kenbrinkman/aquapi/assets/3D MODELS/ezo-conductivity-circuit-1/Circuito EC.JPG

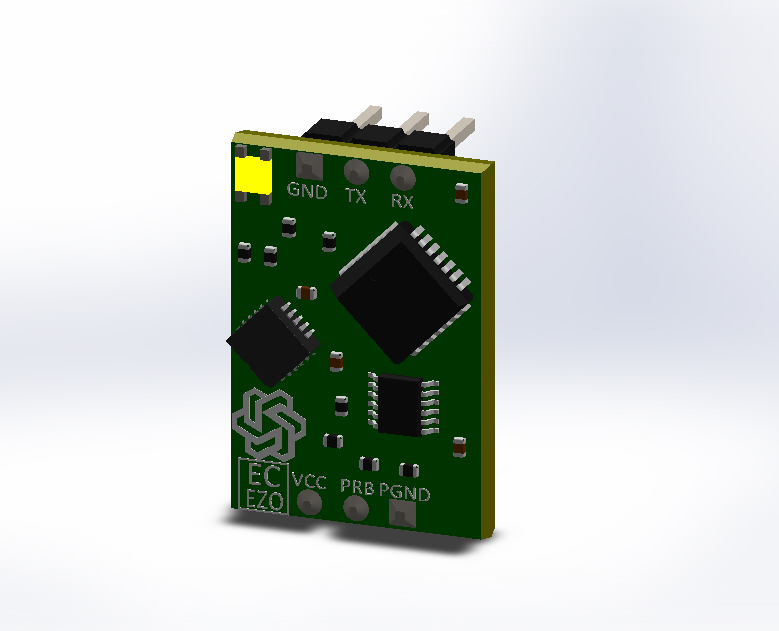
assets/3D MODELS/ezo-conductivity-circuit-1/Circuito EC.JPG
