kenbrinkman/aquapi/assets/STLModels/AquaPiCase/case_views.png

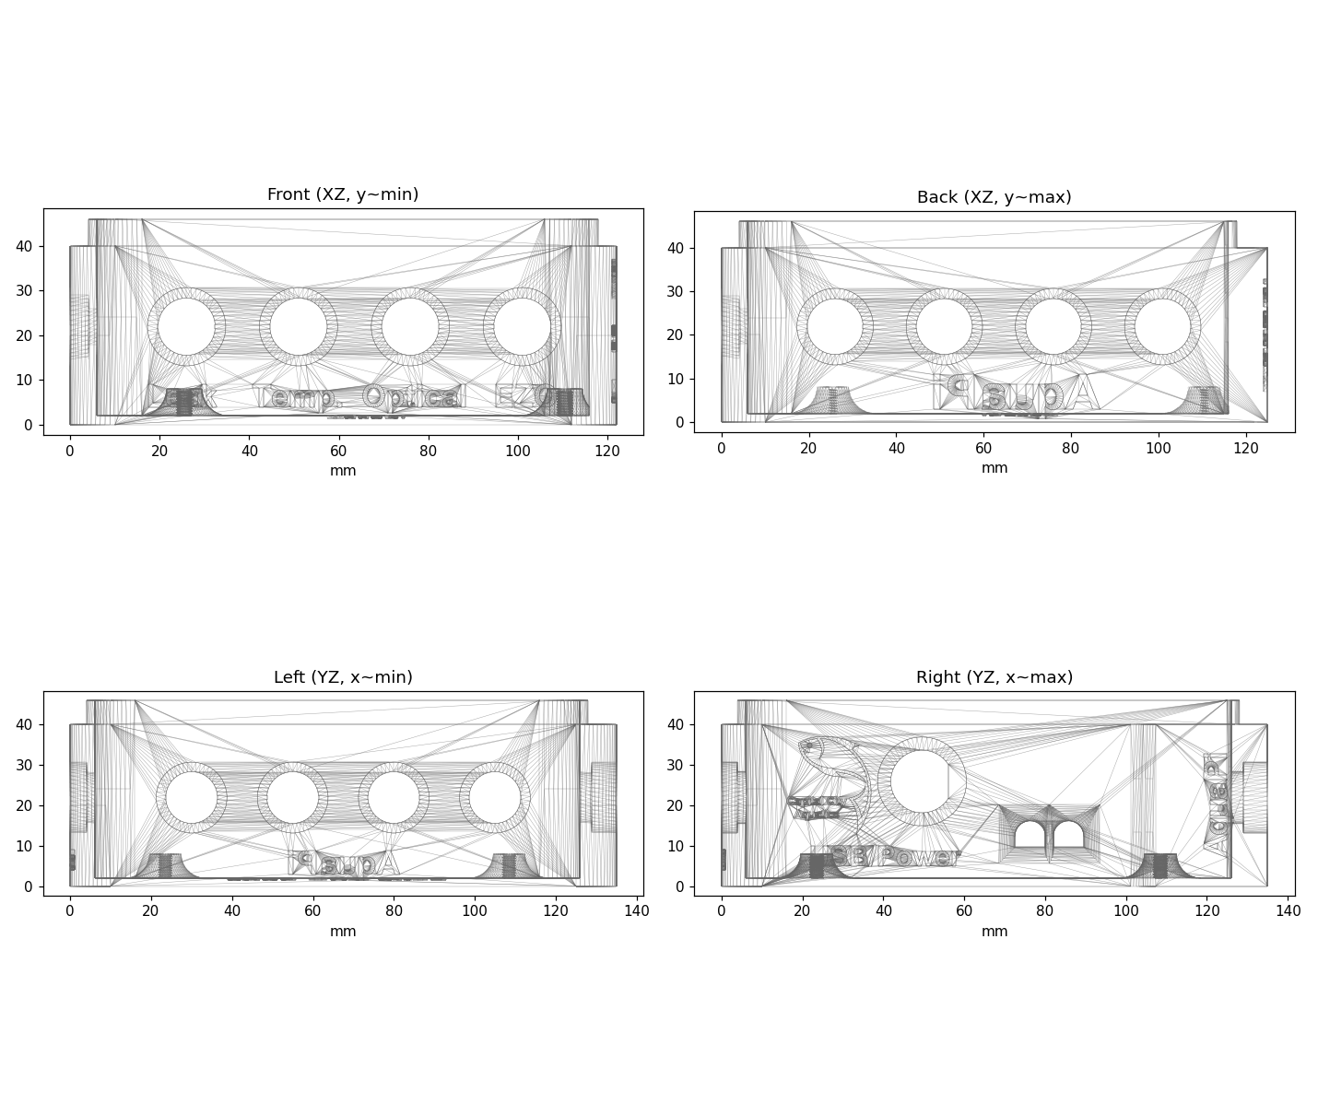
assets/STLModels/AquaPiCase/case_views.png
