kenbrinkman/aquapi/assets/STLModels/AquaPiCase/wall_sections.png

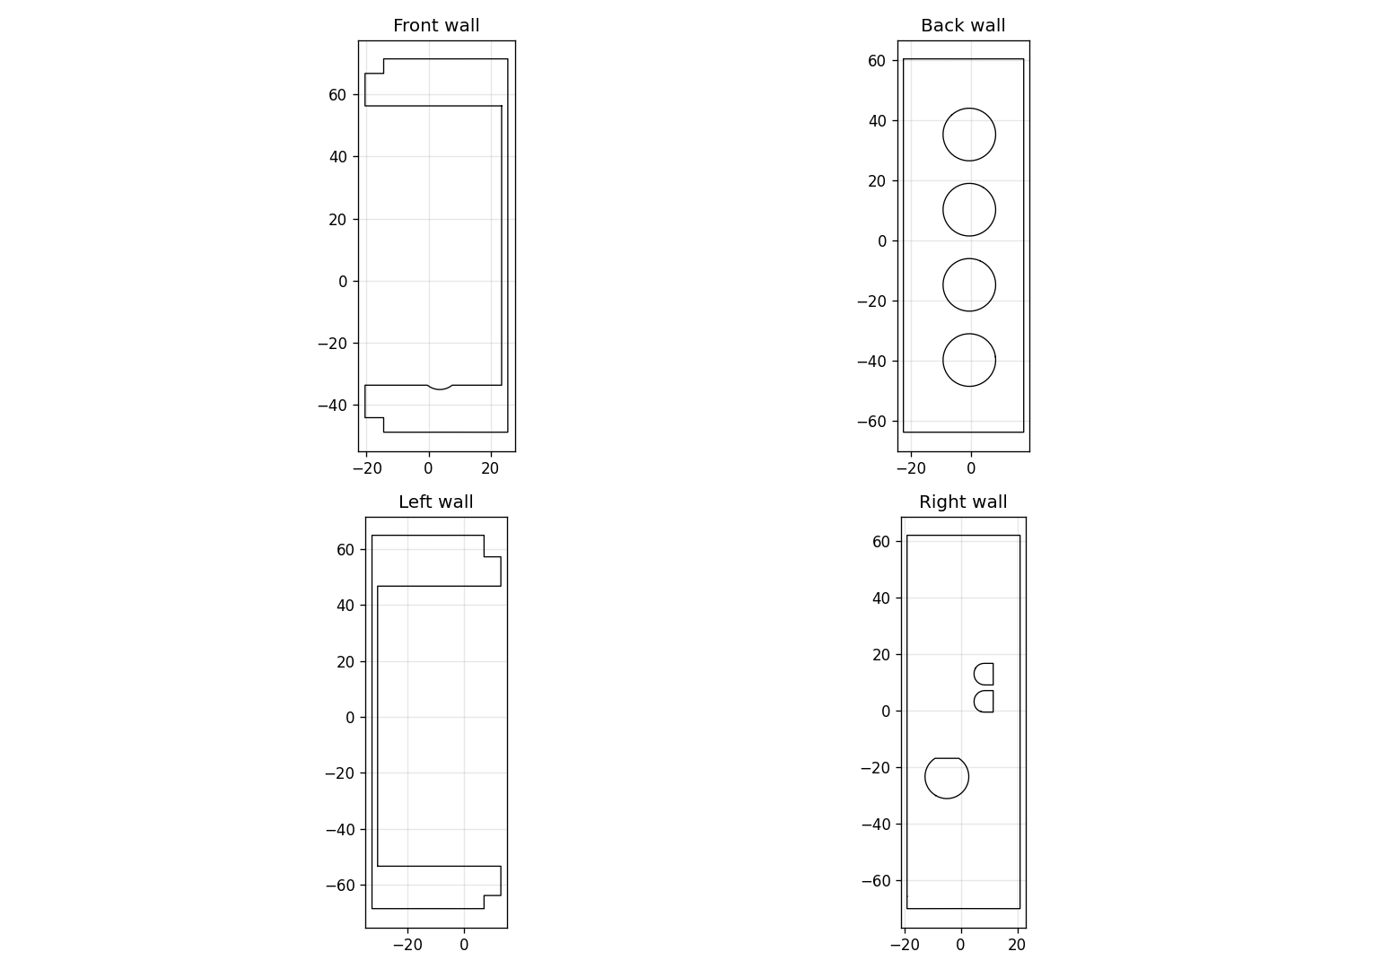
assets/STLModels/AquaPiCase/wall_sections.png
