kenbrinkman/aquapi/assets/3D MODELS/221-415.STEP

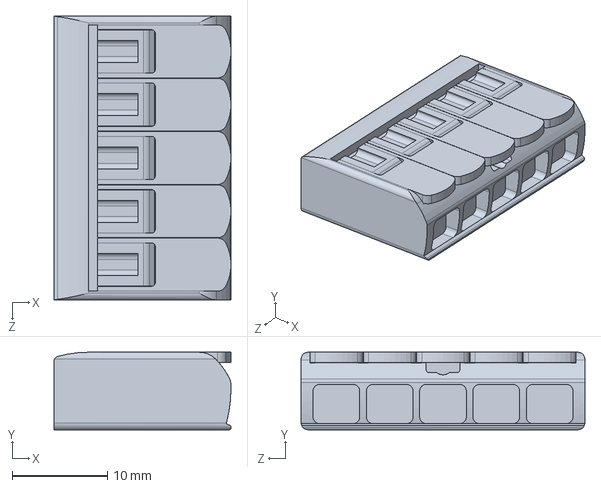
[picture p4: CAD file, 2026-07-17]
assets/3D MODELS/221-415.STEP
18.6 x 8.15 x 29.8 mm
