kenbrinkman/aquapi/assets/3D MODELS/ezo-conductivity-circuit-1/Circuito EC.STEP

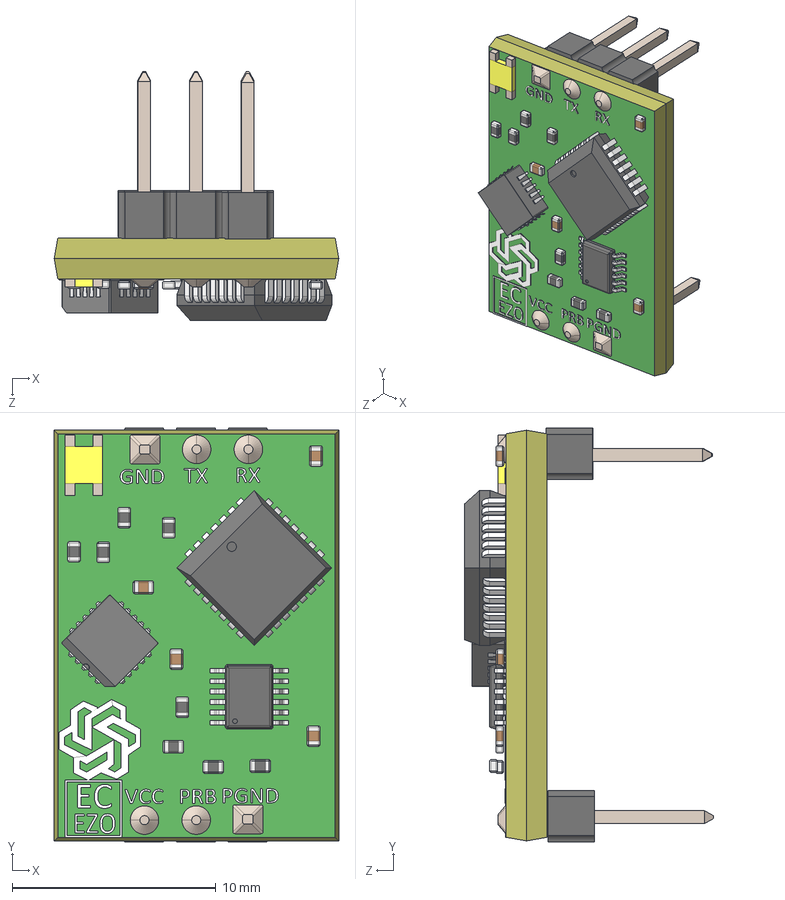
[picture p5: CAD file, 2026-07-17]
assets/3D MODELS/ezo-conductivity-circuit-1/Circuito EC.STEP
14.0 x 20.3 x 12.2 mm
2.terminal x 6
pe蓷 base
1.smd resistor x 8
14.capacitor smd x 4
7.smd 12 terminais___ _________
9. smd pin28
10.PLCC20
