kenbrinkman/aquapi/assets/3D MODELS/PG7.STEP

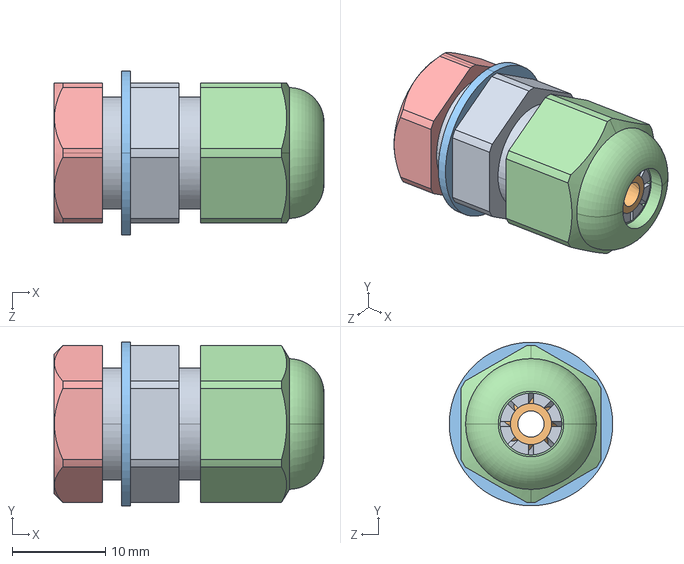
[picture p6: CAD file, 2026-07-17]
assets/3D MODELS/PG7.STEP
28.9 x 17.5 x 17.5 mm
