kenbrinkman/aquapi/assets/3D MODELS/Electrically Isolated EZO Carrier Board.STEP

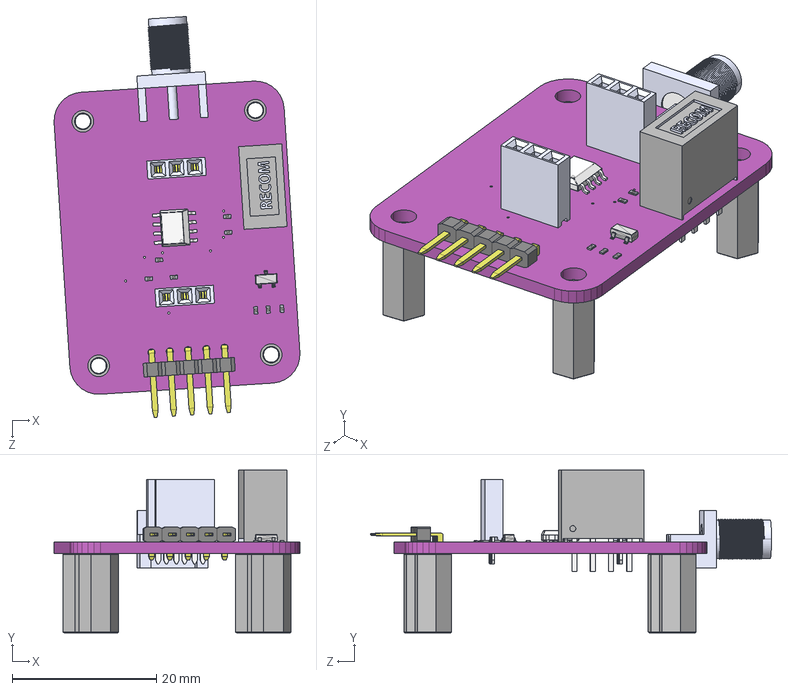
[picture p7: CAD file, 2026-07-17]
assets/3D MODELS/Electrically Isolated EZO Carrier Board.STEP
34.1 x 22.6 x 55.7 mm
standoff x 4
Board_Iso_carry_type-II.step
hdr-1x5th_1.27_6x5.step
User_Library-RO-0505.step
soic-8_150mil.step
hdrf-1x3t_2.54_8x3.step x 2
res_0402.step x 8
sot23.step
SMA edge mount
