kenbrinkman/aquapi/assets/3D MODELS/PG9.STEP

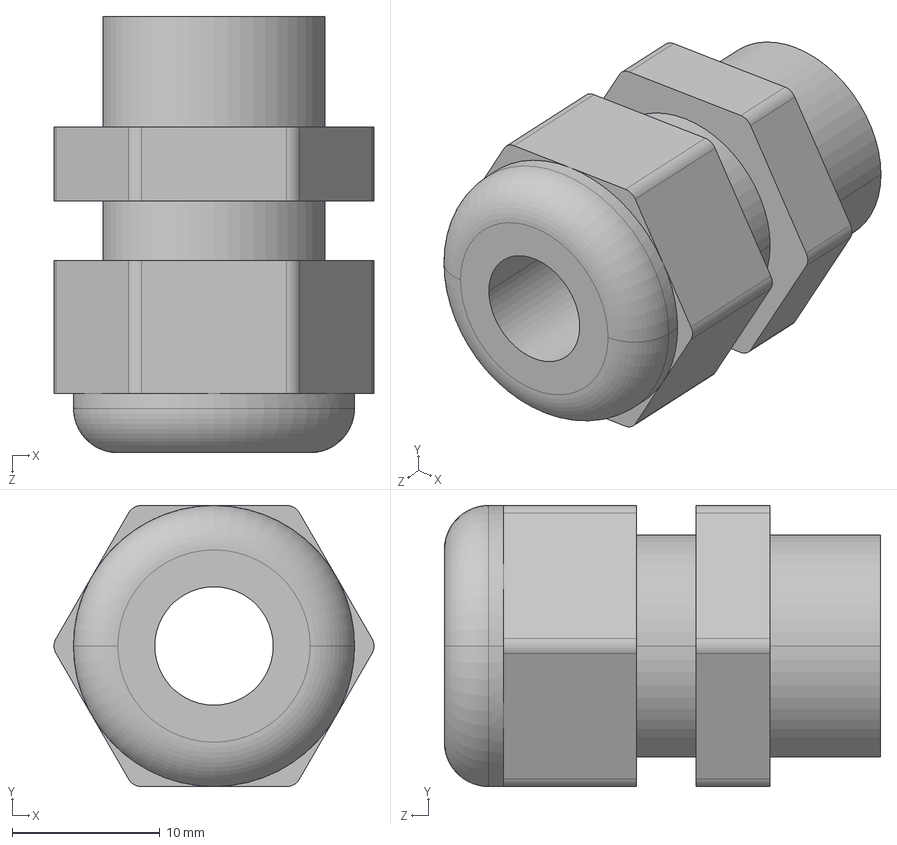
[picture p8: CAD file, 2026-07-17]
assets/3D MODELS/PG9.STEP
21.6 x 19.0 x 29.5 mm
