kenbrinkman/aquapi/assets/3D MODELS/WIZ850IO.STEP

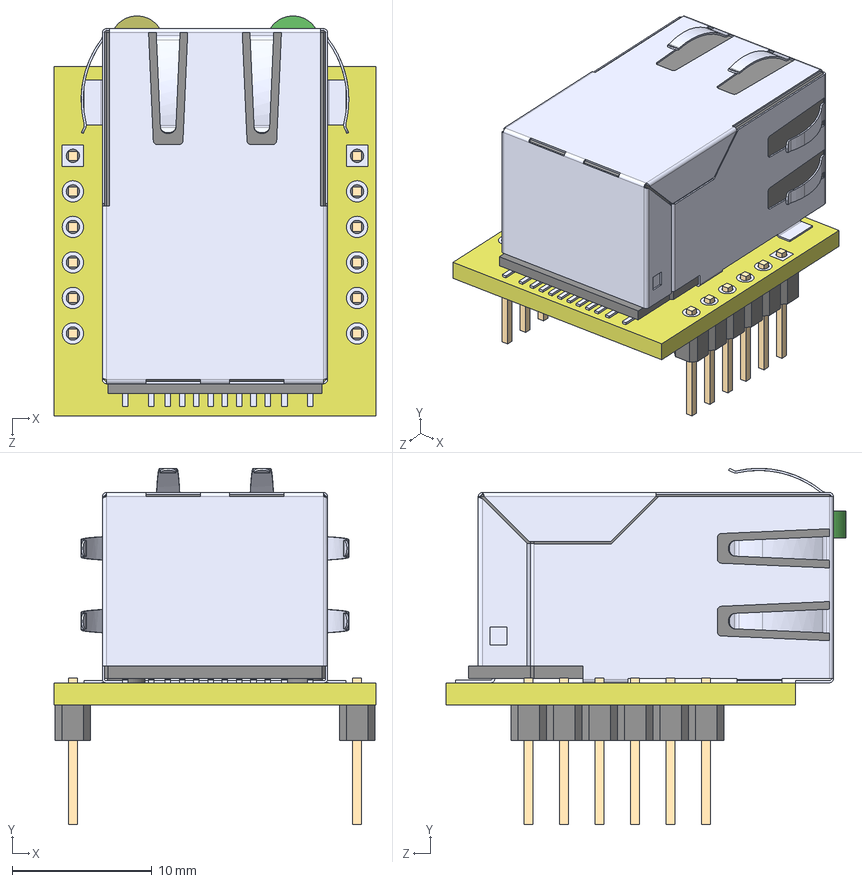
[picture p9: CAD file, 2026-07-17]
assets/3D MODELS/WIZ850IO.STEP
23.0 x 25.5 x 28.6 mm
