kenbrinkman/aquapi/(list of files, cad)

Other CAD files:
assets/3D MODELS/ezo-orp-circuit-1/Circuito ORP.STEP
assets/3D MODELS/ezo-ph-circuit-1/Circuito pH.STEP
assets/3D MODELS/Circuito ORP.stl
assets/3D MODELS/Circuito EC.stl
assets/3D MODELS/Circuito pH.stl
assets/3D MODELS/221-415.stl
assets/3D MODELS/Electrically Isolated EZO Carrier Board.stl
assets/3D MODELS/PG7.stl
assets/3D MODELS/PG9.stl
assets/3D MODELS/WIZ850IO.stl
