kenbrinkman/aquapi/common/temperature_dallas_address.yaml

---
# =============================================================================
# Dallas DS18B20 temperature — ADDRESS-BASED (replaces temperature_dallas_index.yaml)
# =============================================================================
# Why address instead of index:
#   With `index:`, the probes are numbered by their position in the ROM-sorted
#   scan order. If a probe dies or is unplugged, the survivor is promoted to
#   index 0 — so "Temperature" silently starts reporting the *other* probe, and
#   its baked-in calibration is now applied to the wrong sensor. With
#   `address:`, a missing probe simply goes unavailable and the other one keeps
#   reporting itself. Probe swaps become explicit (edit the address here).
#
# HOW TO GET THE ADDRESSES (done 2026-07-30 — kept for the next rebuild):
#   1. Flash with the existing index-based file still included.
#   2. GOTCHA: the bus dump is logged at CONFIG level, which is SUPPRESSED at
#      the default logger level of INFO set in common/device_base_ethernet.yaml.
#      Set `logger: "DEBUG"` in the top-level substitutions of the device YAML
#      first, or the dump never reaches the log and it looks like the reboot
#      failed. Revert to INFO once captured.
#   3. Open the ESPHome logs and look for the one_wire bus dump at boot:
#        [C][gpio.one_wire:020]: GPIO 1-wire bus:
#        [C][gpio.one_wire:087]:   Found devices:
#        [C][gpio.one_wire:090]:     0x8a00000023e44428 (DS18B20)
#        [C][gpio.one_wire:090]:     0xbf00000021744328 (DS18B20)
#   ⚠ CAPTURE GOTCHA (cost a cycle 2026-09-02): the dump is emitted ~3 s after
#      boot, BEFORE the API log stream reconnects. Pressing the Restart button
#      (or HA's restart) while `esphome logs` is attached MISSES IT ENTIRELY —
#      the stream drops on reboot and comes back ~6 s later, after dump_config
#      has already run. You get a clean-looking log with no [C] block at all.
#      USE `esphome run`, which reconnects immediately after its own OTA and
#      reliably catches the dump from [I][app:151] onward.
#      The later [C][dallas.temp.sensor:033] lines are more useful still —
#      they print the address each sensor actually resolved to, in YAML order,
#      which maps index -> address without any guessing.
#   4. Identify which is which: put ONE probe in a cup of warm water, watch
#      which entity moves. Label that physical probe with a tag.
#   5. Paste the addresses below, swap the include, re-flash.
#
# NOTE: the 4.7 kΩ 1-wire pull-up is ALREADY on the AquaPi board (R3, between
# DATA and 3V3). Do not add another — a second pull-up in parallel halves the
# effective resistance and can corrupt reads on longer runs. (REV E.1 of the
# junction box deleted the DROK V1738 carriers, which each carried their own
# on-board 4.7 kΩ; the bus is now on R3 alone, as this note always claimed.)
#
# =============================================================================
# FAILURE VISIBILITY — read this before touching the `filters:` blocks
# =============================================================================
# Until 2026-09-02 both sensors carried `filter_out: NAN` plus a range lambda
# that `return {}`-ed out-of-band values. BOTH OF THOSE DROP THE READING: the
# component publishes nothing, the entity never transitions to unavailable, and
# Home Assistant serves the last good state forever. On 2026-09-01 that hid two
# dead probes for nine days — temp_1 pinned at 74.8625030517578 the whole time,
# indistinguishable from a healthy stable tank.
#
# The rule that came out of it: A FILTER THAT HIDES BAD DATA ALSO HIDES NO DATA.
# So this file now fails loudly, in three layers:
#
#   1. The range lambda returns NAN (not `{}`) for an implausible reading, so
#      the bad value is PUBLISHED as NAN and HA shows "unknown".
#   2. A `timeout:` filter publishes NAN if nothing arrives for ${stale_timeout},
#      which catches a bus that stops answering entirely — a cut wire, a pulled
#      WAGO lever, a ROM address that is not on the bus. No range filter can
#      ever see that case.
#   3. A per-probe `device_class: problem` binary sensor mirrors isnan(), so the
#      fault is a first-class HA entity you can alert and badge on, rather than
#      something you have to notice by staring at a number.
#
# ⚠ If you ever add a plausibility filter to ANY sensor on this device, add the
#   matching staleness check in the SAME change. Never re-introduce
#   `filter_out: NAN` here.
# =============================================================================

substitutions:
  dallasPin: "16"
  update_temp: "60s"

  # Staleness watchdog. If a sensor publishes nothing for this long, emit NAN so
  # the entity goes "unknown" in HA instead of freezing on its last good value.
  # Must be a comfortable multiple of update_temp (60s) so a single missed read
  # does not trip it. 300s == 5 missed reads.
  stale_timeout: "300s"

  # --- Probe ROM addresses -----------------------------------------------
  # 64-bit 1-wire ROM codes. Enumerated on GPIO16 at 12-bit resolution.
  #
  # ✅ CAPTURED 2026-09-06 15:09 — the two NEW DigiKey DS18B20s fitted after the
  #    intermittent DAT/GND short. Both appeared in one boot dump:
  #      [C][gpio.one_wire:090]:     0x40000010ab151428 (DS18B20)
  #      [C][gpio.one_wire:090]:     0x8b000010ab7bbb28 (DS18B20)
  #    Captured with logger: "DEBUG" set in common/reef_overrides.yaml (the LAST
  #    package, so it wins) — NOT by swapping to temperature_dallas_index.yaml,
  #    which still carries the pre-2026-09-02 NAN-dropping filters. See the
  #    warning header on that file; the old "keep _index.yaml for re-reading
  #    addresses" advice is retired.
  #
  # ✅ T1/T2 MAPPING VERIFIED 2026-09-06 ~15:20 — hand-warm test, one probe at a
  #    time. Lifted the probe wired to the T1 terminal, held it in hand, watched
  #    'Temperature' rise and 'Temperature 2' hold. Returned it, lifted the T2
  #    probe, watched 'Temperature 2' rise. Both tracked their own entity, so the
  #    assignment below is CONFIRMED, not inferred from dump order.
  #
  # 🔑 The addresses were pasted in blind (a coin flip) and came out right, but
  #    do NOT read that as "the dump order matches YAML order" — it does not, and
  #    it was luck. The hand-warm test is what makes this line trustworthy.
  #
  # ⚠ Keep the hand-warm under ~100 °F. The range lambda below NANs anything
  #   above 40 °C (104 °F), so a hot-water cup makes a healthy probe read
  #   "unknown" mid-test and look like the failure you are testing for. Body
  #   heat is ideal: it moved both probes ~5 °F, which is far more than enough.
  #
  # 🔑 BONUS, worth remembering: the hand-warm doubles as a LIVENESS KICK. HA's
  #   reef_sump_t{1,2}_movement_1h helpers (statistics, distance_absolute) sat at
  #   0.0 after the outage because the sump was drifting at only 0.20 °F/h and
  #   the 12-bit quantum is 0.1125 °F — a HEALTHY probe needs ~34 min to move one
  #   step, so the vote would not seat the second probe for half an hour. Warming
  #   each probe by hand pushed both helpers to 5.06 and the verdict reached OK
  #   within two minutes.
  #
  # For a future rebuild, the zero-inference method (no hand-warm needed):
  #    boot with ONLY the T1 probe's DAT lever closed. The bus dump then lists
  #    exactly ONE address — that is addr_temp_1. Close T2's lever, reboot, and
  #    the newly appeared address is addr_temp_2.
  #
  # HISTORICAL — superseded, kept so an old log line can still be identified:
  #    0xbf00000021744328 / 0x8a00000023e44428  dead Amazon/clone probes (7/30)
  #    0xb100000025f23928 / 0x6e00000025e47428  Olimex probes, removed 9/06 after
  #                                             the intermittent short (torched
  #                                             heat-shrink, see project docs)
  addr_temp_1: "0x40000010ab151428"  # T1 terminal — DigiKey, hand-warm verified 9/06
  addr_temp_2: "0x8b000010ab7bbb28"  # T2 terminal — DigiKey, hand-warm verified 9/06

  # ✅ CAPTURED 2026-09-08 23:54 — junction box REV F, third probe on the bus.
  #    Boot dump (logger DEBUG, build 26.6.11) listed T1, T2 and exactly ONE new
  #    address, so this needs no inference. ✅ CONFIRMED 2026-09-08 00:00 — hot tap
  #    then cold on the AMB tip moved only 'Basement Ambient Temperature'; T1 in
  #    hand moved only 'Temperature'. All three mappings physically proven.
  # ⚠ AMB is BASEMENT AIR, not a sump probe. It must never be referenced from
  #   temp_delta, temp_probes_disagree, or any HA vote/verdict helper
  #   (reef_sump_probes_ok, reef_temp_verdict, the *_movement_1h helpers).
  #   A basement-air voter sits 5–10 °F off the sump and fails the band forever.
  addr_temp_amb: "0x9b000010ab5d7e28"  # AMB terminal — DigiKey, basement ambient
  stale_timeout_amb: "300s"

  # Calibration variables
  # 0C using Ice Water; 100C using Boiling Water
  # (calibration happens in °C, before the °F conversion filter)
  #
  # Calibration Temp. 1
  # RESET 2026-07-28 for the rebuilt probe harness. The previous
  # cal_0/cal_100 of 0.389/100.389 was a +0.7°F bias offset derived on
  # 2026-07-08 against the OLD T2 as reference — that reference probe is
  # dead and both probes are being re-terminated, so the old offset is
  # meaningless. Re-derive after the rebuild: let both probes settle in the
  # same water, then bias whichever reads low.
  cal_0: "0.0"
  cal_100: "100.0"
  # Cool/Warm thresholds in °F (was 23.5/28 °C)
  range_cool: "74.3"
  range_warm: "82.4"

  # Calibration Temp. 2
  cal_0_temp_2: "0.0"
  cal_100_temp_2: "100.0"
  range_cool_2: "74.3"
  range_warm_2: "82.4"

  sorting_group_temperature_weight: '10'

web_server:
  sorting_groups:
    - id: sorting_group_temperature
      name: "Temperature"
      sorting_weight: ${sorting_group_temperature_weight}

# 18B20 sensor Pin
one_wire:
  - platform: gpio
    pin: ${dallasPin}

sensor:
  # Temperature Probe 1 - pinned to its ROM address
  - platform: dallas_temp
    address: ${addr_temp_1}
    id: temp_1
    icon: mdi:thermometer-water
    name: "Temperature"
    state_class: "measurement"
    device_class: "temperature"
    unit_of_measurement: "°F"
    update_interval: "${update_temp}"
    resolution: 12
    accuracy_decimals: 2
    filters:
      # ⚠ DELIBERATELY NO `filter_out: NAN` — see FAILURE VISIBILITY in the header.
      # Reject implausible raw readings (°C, pre-calibration) by PUBLISHING NAN,
      # never by dropping them: 85.0 = DS18B20 power-on-reset default,
      # 0.0 / -127 = bus glitch. Outside 4-40°C (39-104°F) is not a tank temp.
      - lambda: |-
          if (isnan(x) || x < 4.0 || x > 40.0) return NAN;
          return x;
      - calibrate_linear:
          method: least_squares
          datapoints:
            - 0.0 -> ${cal_0}
            - 100.0 -> ${cal_100}
      # Convert to Fahrenheit (calibration above stays in °C)
      - lambda: return x * 9.0 / 5.0 + 32.0;
      # Watchdog — MUST BE LAST. Nothing published for ${stale_timeout} -> NAN.
      # This is the layer that catches a bus which stops answering completely.
      - timeout: ${stale_timeout}
    on_value:
      then:
        - component.update: temp_range
    web_server:
      sorting_group_id: sorting_group_temperature
      sorting_weight: 10

  # Calibration Temp. at 0C
  - platform: template
    name: Calibration at 0°C - Temp. 1
    id: cal_0_sen
    icon: mdi:thermometer-low
    unit_of_measurement: "°C"
    disabled_by_default: true
    state_class: "measurement"
    device_class: "temperature"
    entity_category: "diagnostic"
    lambda: |-
      return {${cal_0}};
    web_server:
      sorting_group_id: sorting_group_temperature

  # Calibration Temp. at 100C
  - platform: template
    name: Calibration at 100°C - Temp. 1
    id: cal_100_sen
    icon: mdi:thermometer-high
    unit_of_measurement: "°C"
    disabled_by_default: true
    state_class: "measurement"
    device_class: "temperature"
    entity_category: "diagnostic"
    lambda: |-
      return {${cal_100}};
    web_server:
      sorting_group_id: sorting_group_temperature

  # Temperature Probe 2 - pinned to its ROM address
  - platform: dallas_temp
    address: ${addr_temp_2}
    id: temp_2
    icon: mdi:thermometer-water
    name: "Temperature 2"
    state_class: "measurement"
    device_class: "temperature"
    unit_of_measurement: "°F"
    update_interval: "${update_temp}"
    resolution: 12
    accuracy_decimals: 2
    filters:
      # ⚠ DELIBERATELY NO `filter_out: NAN` — see Temp 1 and the header.
      - lambda: |-
          if (isnan(x) || x < 4.0 || x > 40.0) return NAN;
          return x;
      - calibrate_linear:
          method: least_squares
          datapoints:
            - 0.0 -> ${cal_0_temp_2}
            - 100.0 -> ${cal_100_temp_2}
      # Convert to Fahrenheit (calibration above stays in °C)
      - lambda: return x * 9.0 / 5.0 + 32.0;
      # Watchdog — MUST BE LAST. See Temp 1.
      - timeout: ${stale_timeout}
    on_value:
      then:
        - component.update: temp_range_2
    web_server:
      sorting_group_id: sorting_group_temperature
      sorting_weight: 60

  # Calibration Temp. 2 at 0C
  - platform: template
    name: Calibration at 0°C - Temp. 2
    id: cal_0_2_sen
    disabled_by_default: true
    icon: mdi:thermometer-low
    unit_of_measurement: "°C"
    state_class: "measurement"
    device_class: "temperature"
    entity_category: "diagnostic"
    lambda: |-
      return {${cal_0_temp_2}};
    web_server:
      sorting_group_id: sorting_group_temperature
      sorting_weight: 69

  # Calibration Temp. 2 at 100C
  - platform: template
    name: Calibration at 100°C - Temp. 2
    id: cal_100_2_sen
    disabled_by_default: true
    icon: mdi:thermometer-high
    unit_of_measurement: "°C"
    state_class: "measurement"
    device_class: "temperature"
    entity_category: "diagnostic"
    lambda: |-
      return {${cal_100_temp_2}};
    web_server:
      sorting_group_id: sorting_group_temperature
      sorting_weight: 69

  # --- Basement ambient — a SENSOR, not a voter ------------------------------
  # Third DS18B20 on the same bus (R3 is still the only pull-up). Reports the air
  # around the sump so HA can later derive sump − ambient for the cooling
  # decision. Never reference this id from temp_delta / temp_probes_disagree or
  # from any HA sump-vote helper. Range is AIR (-5..50 °C), not tank, and the
  # staleness watchdog ships in the same change, per the header rule.
  - platform: dallas_temp
    address: ${addr_temp_amb}
    id: temp_amb
    icon: mdi:thermometer
    name: "Basement Ambient Temperature"
    state_class: "measurement"
    device_class: "temperature"
    unit_of_measurement: "°F"
    update_interval: "${update_temp}"
    resolution: 12
    accuracy_decimals: 2
    filters:
      # ⚠ NO filter_out: NAN — publish NAN so HA shows unknown (see header).
      # 85.0 = DS18B20 power-on default, -127 / 0.0 = bus glitch.
      - lambda: |-
          if (isnan(x) || x < -5.0 || x > 50.0) return NAN;
          return x;
      - lambda: return x * 9.0 / 5.0 + 32.0;
      # Watchdog — MUST BE LAST.
      - timeout: ${stale_timeout_amb}
    web_server:
      sorting_group_id: sorting_group_temperature
      sorting_weight: 80

  # --- Probe agreement --------------------------------------------------------
  # T1 and T2 sit in the SAME 75 gal sump, so in steady state they must track
  # each other. This is the ONLY check that can catch a probe frozen on a
  # PLAUSIBLE value — the failure mode that hid two dead probes for nine days.
  # A range filter cannot see it (74.86°F is a perfectly sensible tank temp) and
  # neither can the ${stale_timeout} watchdog (a frozen DS18B20 keeps happily
  # publishing its stale scratchpad value every ${update_temp}). But real sump
  # temperature drifts a couple of °F across a day, so a stuck probe walks away
  # from its neighbour within hours and this number climbs.
  #
  # NAN if EITHER probe is faulted — a missing probe is reported by the
  # "Temp Probe Fault" sensors, not here, so the two alerts stay independent.
  - platform: template
    name: "Temp Probe Disagreement"
    id: temp_delta
    icon: mdi:thermometer-minus
    unit_of_measurement: "°F"
    accuracy_decimals: 2
    state_class: "measurement"
    device_class: "temperature"
    entity_category: "diagnostic"
    update_interval: "${update_temp}"
    lambda: |-
      if (isnan(id(temp_1).state) || isnan(id(temp_2).state)) {
        return NAN;
      }
      return fabs(id(temp_1).state - id(temp_2).state);
    web_server:
      sorting_group_id: sorting_group_temperature
      sorting_weight: 70

binary_sensor:
  - platform: template
    name: Ideal Temperature
    id: ideal_temp
    icon: mdi:thermometer-check
    lambda: |-
      if (id(temp_range).state == "OK") {
        return true;
      } else {
        return false;
      }
    web_server:
      sorting_group_id: sorting_group_temperature

  - platform: template
    name: Ideal Temperature 2
    id: ideal_temp_2
    icon: mdi:thermometer-check
    lambda: |-
      if (id(temp_range_2).state == "OK") {
        return true;
      } else {
        return false;
      }
    web_server:
      sorting_group_id: sorting_group_temperature
      sorting_weight: 69

  # --- Probe fault ------------------------------------------------------------
  # device_class problem => true means PROBLEM (HA renders "Detected" / red).
  # Faulted whenever the sensor holds no valid number, which now covers every
  # failure mode: probe unplugged or dead, ROM address not present on the bus
  # (e.g. a probe was swapped and addr_temp_* above was not updated), an
  # implausible reading such as the 85°C power-on-reset value, or the
  # ${stale_timeout} watchdog having fired on a silent bus.
  #
  # This is the entity to alert on. Do NOT alert on the temperature going
  # "unavailable" — that only ever fires when the whole AquaPi drops off the
  # network, never when a single probe dies.
  - platform: template
    name: "Temp Probe Fault"
    id: temp_1_fault
    icon: mdi:thermometer-alert
    device_class: problem
    lambda: |-
      return isnan(id(temp_1).state);
    web_server:
      sorting_group_id: sorting_group_temperature
      sorting_weight: 13

  - platform: template
    name: "Temp Probe 2 Fault"
    id: temp_2_fault
    icon: mdi:thermometer-alert
    device_class: problem
    lambda: |-
      return isnan(id(temp_2).state);
    web_server:
      sorting_group_id: sorting_group_temperature
      sorting_weight: 63

  # Ambient probe fault — same isnan() mirror as the sump probes. Diagnostic;
  # it is NOT part of the sump pair and must not feed reef_temp_fault.
  - platform: template
    name: "Ambient Temp Probe Fault"
    id: temp_amb_fault
    icon: mdi:thermometer-alert
    device_class: problem
    entity_category: diagnostic
    lambda: |-
      return isnan(id(temp_amb).state);
    web_server:
      sorting_group_id: sorting_group_temperature
      sorting_weight: 81

  # Trips when the two probes drift apart by more than the configurable
  # threshold. delayed_on debounces it: a single odd sample, or the transient
  # while one probe is lifted out of the water for service, must not alarm.
  #
  # Returns false while the delta is NAN. That is deliberate: a faulted probe is
  # already reported by "Temp Probe Fault", and double-alarming one failure as
  # two problems is how alerting gets ignored.
  - platform: template
    name: "Temp Probes Disagree"
    id: temp_probes_disagree
    icon: mdi:thermometer-alert
    device_class: problem
    filters:
      - delayed_on: 15min
    lambda: |-
      if (isnan(id(temp_delta).state)) {
        return false;
      }
      return id(temp_delta).state > id(temp_delta_max).state;
    web_server:
      sorting_group_id: sorting_group_temperature
      sorting_weight: 71

text_sensor:
  # Temperature Range 1
  - platform: template
    name: Temperature Range
    id: temp_range
    icon: mdi:thermometer-alert
    update_interval: "${update_temp}"
    lambda: |-
      if (isnan(id(temp_1).state)) {
        return {"Unknown"};
      } else if (id(temp_1).state <= id(range_cool).state) {
        return {"Cool"};
      } else if (id(temp_1).state >= id(range_warm).state) {
        return {"Warm"};
      } else {
        return {"OK"};
      }
    web_server:
      sorting_group_id: sorting_group_temperature
      sorting_weight: 12

  # Temperature Range 2
  - platform: template
    name: Temperature 2 Range
    id: temp_range_2
    icon: mdi:thermometer-alert
    update_interval: "${update_temp}"
    lambda: |-
      if (isnan(id(temp_2).state)) {
        return {"Unknown"};
      } else if (id(temp_2).state <= id(range_cool_2).state) {
        return {"Cool"};
      } else if (id(temp_2).state >= id(range_warm_2).state) {
        return {"Warm"};
      } else {
        return {"OK"};
      }
    web_server:
      sorting_group_id: sorting_group_temperature
      sorting_weight: 62

number:
  # Temperature 1 when Cool
  # NOTE: renamed °C -> °F. The new object_id resets the saved (restore_value)
  # threshold, so the °F initial_value takes effect on first boot after flash.
  - platform: template
    name: "Temp. Cool °F"
    id: range_cool
    icon: mdi:thermometer-low
    optimistic: true
    mode: box
    min_value: 32
    max_value: 104
    step: 0.5
    restore_value: true
    initial_value: ${range_cool}
    entity_category: "Config"
    device_class: "temperature"
    on_value:
      then:
        - component.update: temp_range
    web_server:
      sorting_group_id: sorting_group_temperature

  # Temperature 1 when Warm
  - platform: template
    name: "Temp. Warm °F"
    icon: mdi:thermometer-high
    id: range_warm
    optimistic: true
    mode: box
    min_value: 32
    max_value: 104
    step: 0.5
    restore_value: true
    initial_value: ${range_warm}
    entity_category: "Config"
    device_class: "temperature"
    on_value:
      then:
        - component.update: temp_range
    web_server:
      sorting_group_id: sorting_group_temperature

  # Temperature 2 when Cool
  - platform: template
    name: "Temp. 2 Cool °F"
    id: range_cool_2
    icon: mdi:thermometer-low
    optimistic: true
    mode: box
    min_value: 32
    max_value: 104
    step: 0.5
    restore_value: true
    initial_value: ${range_cool_2}
    entity_category: "Config"
    device_class: "temperature"
    on_value:
      then:
        - component.update: temp_range_2
    web_server:
      sorting_group_id: sorting_group_temperature
      sorting_weight: 69

  # Temperature 2 when Warm
  - platform: template
    name: "Temp. 2 Warm °F"
    icon: mdi:thermometer-high
    id: range_warm_2
    optimistic: true
    mode: box
    min_value: 32
    max_value: 104
    step: 0.5
    restore_value: true
    initial_value: ${range_warm_2}
    entity_category: "Config"
    device_class: "temperature"
    on_value:
      then:
        - component.update: temp_range_2
    web_server:
      sorting_group_id: sorting_group_temperature
      sorting_weight: 69

  # Max tolerated spread between the two sump probes before "Temp Probes
  # Disagree" trips. Genuine DS18B20-to-DS18B20 spread on the bench after the
  # 2026-07-30 flash was 0.2°F, and datasheet tolerance is +/-0.9°F, so 1.0°F is
  # comfortably above honest disagreement while still catching a stuck probe
  # within hours of it sticking. Tune DOWN once both probes are wet, settled and
  # calibrated — the tighter this is, the sooner a freeze is caught.
  - platform: template
    name: "Temp Probe Max Disagreement °F"
    id: temp_delta_max
    icon: mdi:thermometer-alert
    optimistic: true
    mode: box
    min_value: 0.1
    max_value: 10
    step: 0.1
    restore_value: true
    initial_value: 1.0
    entity_category: "Config"
    device_class: "temperature"
    web_server:
      sorting_group_id: sorting_group_temperature
      sorting_weight: 72
