kenbrinkman/aquapi/(commit log)

2026-07-07 Add live temperature compensation to EC, pH, and DO circuits
2026-07-12 Pre-flash checkpoint: Ethernet build + GR-402B RODI flow meter on GPIO27
    - rodi_flow.yaml: flow rate (gal/h), lifetime total (gal, restored), new
    'RODI This Run' session volume, producing threshold converted to gal/h
    - Ethernet variant files (W5500 base, binary without leak sensor)
    - EC scoring rescaled for seawater (mS/cm)
    [temperature_dallas_index.yaml, water_quality.yaml]
2026-07-12 Add Ethernet build wiring reference (W5500, GR-402B flow meter, optical sensors)
2026-07-17 RODI flow meter: power moved 3V3 -> 5V aux terminal (2026-07-12)
    Keeps load off the shared 3V3 rail (I2C + W5500). Signal stays GPIO-safe:
    open-collector output only pulls low; line idles at 3.3 V via the internal
    pull-up. Wiring-only change, no firmware impact. Also ignore .DS_Store.
2026-07-17 Reconcile optical LOW/HIGH pin comments with flashed firmware
    Canonical: LOW = GPIO33, HIGH = GPIO32. As wired on this board:
    yellow harness leg = HIGH/D32, blue leg (pigtail white) = LOW/D33 —
    opposite the old harness color convention. Verified against the compiled
    aquapi_config_ethernet.yaml. water_level.yaml remains authoritative.
2026-07-17 Add reference assets: EZO/W5500/case 3D models, case renders, WIZ850io datasheet
    [221-415.STEP, 221-415.stl, Circuito EC.STEP, Circuito EC.stl, Circuito ORP.STEP, Circuito ORP.stl, Circuito pH.STEP, Circuito pH.stl]
2026-07-26 EZO Plock buttons + I2C presence detection; bump app_version to 26.6.7
    EC circuit booted into UART mode after the ferrule/reseat repair (green LED,
    others blue). The EZO hardware protocol switch is 'TX shorted to PGND at
    power-up with RX not driving', and that procedure is identical in both
    directions, so a qualifying boot toggles the protocol every time. EC is the
    only circuit with a low-impedance probe path to PGND (~48 mS/cm seawater);
    pH/ORP/DO are gigaohm potentiometric. Plock,1 blocks the hardware switch.
    - common/ezo_lock.yaml: Lock/Unlock buttons for the 4 installed circuits.
    - common/i2c_detection_reef.yaml: per-circuit bus-presence sensors.
    - common/aquapi.yaml: app_version 26.6.6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
2026-07-28 DS18B20: migrate from bus index to ROM address
    - New common/temperature_dallas_address.yaml: sensors pinned to
    addr_temp_1/addr_temp_2 ROM substitutions instead of index 0/1, so a
    dead probe goes unavailable instead of silently promoting the survivor
    (and its calibration) to index 0
    - Commented address-based dallas: include staged in all three configs,
    ready to flip once the ROM codes are read from a boot log
    - Cal offsets reset to 0.0/100.0 (old T1 bias was derived against the
    now-dead T2); re-derive after the harness rebuild
    - isnan guard moved to the front of the temp_range lambdas; 4-40 C
    plausibility filter carried in both files
    - Entity names/IDs/weights byte-identical to t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
    [temperature_dallas_address.yaml]
2026-07-31 DS18B20: cut over to ROM addressing, drop stale T1 calibration
    Probe ROM codes read off the boot log after the REV D.2 junction box
    rebuild, so the Ethernet build now pins sensors to addresses instead of
    bus index:
    addr_temp_1: 0xbf00000021744328 # T1 terminal
    addr_temp_2: 0x8a00000023e44428 # T2 terminal
    A dead probe now goes unavailable instead of promoting the survivor to
    index 0 and silently reporting it as the tank temp under the dead
    probe's calibration -- which is exactly what happened after the 7/27
    probe failure.
    Calibration: both probes now run uncalibrated (0.0/100.0). The old
    0.389/100.389 bias on T1 was derived on 2026-07-08 against the probe
    that died on 7/27, and wa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
    [temperature_dallas_address.yaml]
2026-09-03 DS18B20: fail loudly on probe death; new Olimex probe addresses
    The old filters silently swallowed sensor failure. `filter_out: NAN` and a
    range lambda returning `{}` BOTH drop the reading, so ESPHome published
    nothing, the entity never went unavailable, and Home Assistant served the
    last good value indefinitely. Temperature 1 held 74.8625030517578 for nine
    days against a dead probe, indistinguishable from a healthy stable tank.
    Rule that came out of it: a filter that hides bad data also hides no data.
    Three independent layers now, because no single one catches every mode:
    1. Range lambda publishes NAN instead of dropping it, so the 85C
    power-on-reset value and bus glitches reach HA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
    [temperature_dallas_address.yaml]
2026-09-03 Track the ESPHome Device Builder entry point
    AquaPi is now built and flashed from the Device Builder container on Tower
    rather than the Mac CLI. The container holds exactly one file, /config/
    aquapi.yaml, whose packages: block pulls every include from this repo over
    https at build time -- so the container cannot build anything that has not
    been pushed here.
    device-builder/aquapi.yaml is the master copy of that file. It was the only
    piece of the setup living outside version control, which is a poor look for
    a layout whose entire purpose is making the repo authoritative.
    Notes carried in the file header:
    - refresh: 0s is mandatory. ESPHome caches remote packages for a day, so
    without it a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
2026-09-03 Share one substitutions file between both flash paths
    The reef-specific knobs -- device name, EC scoring rescaled for seawater,
    logger level, the DO compensation sources -- were duplicated verbatim in
    aquapi_config_ethernet.yaml (Mac CLI) and device-builder/aquapi.yaml (the
    Device Builder container). Editing one and flashing from the other used the
    stale value and said nothing about it, which is the same silent-wrong-value
    failure mode as the NaN filter that froze a dead probe for nine days.
    Both now pull common/reef_overrides.yaml instead.
    The subtlety is precedence. ESPHome documents only that MAIN-config
    substitutions beat package ones, and these have moved INTO a package, where
    they co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
2026-09-06 26.6.9: logger DEBUG to re-capture DS18B20 ROM addresses
    The DigiKey probes are in and the bus is healthy again - the error changed
    from "1-wire bus is held low" (a short) to "scratch pad checksum invalid",
    which is the bus reset succeeding and MATCH ROM finding nobody. The two
    addresses in temperature_dallas_address.yaml are the old Olimex ROMs.
    reef_overrides.yaml is the LAST package, so its logger substitution wins.
    DEBUG un-suppresses the [C] boot dump that lists the ROM addresses. Put it
    back to INFO in the same change that pastes the new addresses in.
    Also: a hard warning header on temperature_dallas_index.yaml. That file is
    the PRE-2026-09-02 version - it still carries filter_out: N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
    [temperature_dallas_index.yaml]
2026-09-06 26.6.10: new DigiKey DS18B20 ROM addresses; logger back to INFO
    Captured from the 26.6.9 install log at 15:09:
    [C][gpio.one_wire:090]: 0x40000010ab151428 (DS18B20)
    [C][gpio.one_wire:090]: 0x8b000010ab7bbb28 (DS18B20)
    Two devices enumerated on a healthy bus, both family code 0x28.
    The T1/T2 assignment is ARBITRARY AND UNVERIFIED and the file says so at
    length. A single dump prints in ROM-sorted bus order, not YAML order, so
    nothing in it identifies which probe sits in which WAGO terminal. That is
    deliberate here and safe only because three things are true today: cal_0/
    cal_100 are 0.0/100.0 on both probes so no per-probe bias can be misapplied,
    both probes sit in the same sump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
2026-09-06 Record the T1/T2 mapping as hand-warm verified
    Comment-only. No behaviour change, so app_version stays 26.6.10 and no
    reflash is needed.
    The addresses were pasted in blind and happened to land correctly, but that
    was a coin flip and the file now says so - the dump order still does not
    match YAML order. What makes the line trustworthy is the hand-warm test:
    each probe lifted separately, each moved its own entity.
    Also recorded the liveness-kick side effect. The HA movement helpers sat at
    0.0 after the outage because the sump drifts at 0.20 F/h against a 0.1125 F
    quantum, so a healthy probe needs ~34 min to register one step and the vote
    would not have seated the second probe for half an hou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
    [temperature_dallas_address.yaml]
2026-09-08 26.6.11: logger DEBUG to capture the basement-ambient DS18B20 address
    Junction box REV F now carries a third probe (AMB) on the 1-Wire bus.
    Temporary build: only the log level changes, so the boot dump lists the
    new ROM address. No sensor added yet. Revert to INFO in the next build.
2026-09-08 26.6.12: add the basement-ambient DS18B20 (temp_amb); logger back to INFO
    Third probe on the REV F junction box, ROM 0x9b000010ab5d7e28, captured
    from the 26.6.11 boot dump as the one new address beside T1 and T2.
    temp_amb is a sensor, not a voter: it is referenced by nothing in the
    probe-agreement layer (temp_delta / temp_probes_disagree read only
    temp_1 and temp_2). Air plausibility range -5..50 C, publishes NAN on
    an implausible read, 300 s staleness watchdog last in the chain, and a
    matching "Ambient Temp Probe Fault" problem binary sensor — all in the
    same change, per the failure-visibility rule in the file header.
    [temperature_dallas_address.yaml]
2026-09-08 Record the AMB address as physically confirmed (26.6.12 flashed, all three probes warm-tested)
2026-09-08 26.6.13: expose the EZO's own specific-gravity field (3 decimals)
    New template sensor "Specific Gravity EZO" (sensor_specific_gravity_ezo)
    returning v[3] of the EC raw string - the SG value exactly as the EZO
    EC circuit reports it, 3 decimals, plausibility-bounded 0.9-1.1 and NAN
    outside it. Updated from raw_value_ec on_value like its siblings.
    Kenny's call: the Command salinity gauge reads this one. It stair-steps
    by 0.001 (about 1.3 ppt) because that is the circuit's resolution, not a
    fault. The EOS-80 derived sensor (4 decimals) is unchanged and keeps
    the smooth history for Trends and InfluxDB.
2026-09-11 ezo_do: add calibration Export/Import, a defaults acceptance read, and a diagnostic routing guard
    Against EZO-DO circuit datasheet V5.8 (rev 3/25).
    - New global do_diag_mode. While set, on_custom publishes to result_do only and
    never to raw_value_do. Without this an Export hex string would be parsed as a
    reading (publishing NaN and blanking the DO channel), and a deliberately
    uncompensated verification read would enter the live DO series as tank data.
    - "Verify Cal @ Atlas Defaults (T,20 / S,0)" sets default compensation and reads
    once, so a calibration can be checked against the datasheet's 9.09-9.1X mg/L
    benchmark (p.63). No DO calibration in this project has ever had a pass/fai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
2026-09-14 26.6.14: boot-time EZO traffic delayed, api reboot_timeout 5min, EC reply routing, diag mode pauses the poller, pH 3 dp
    - api: reboot_timeout: 5min (reef_overrides.yaml) — a node HA cannot reach
    soft-reboots itself sooner; EZO power untouched
    - on_boot EZO commands moved from priority 800 to -100 + 2 s delay in all
    four ezo_*.yaml — after a power cycle the circuits are still booting at 800
    - zero-length I2C ACK probe outside the ezo queue removed (pH interval,
    read buttons, read_ec/read_do); the component reports its own read errors
    - EC on_custom routes '?'/'*' replies and diagnostic-mode payloads to
    EC - Command Result instead of raw_value_ec (salinity/TDS/SG no longer
    blank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
    [ezo_do.yaml]
2026-09-25 26.6.16: Reset Reason text sensor (debug component, reset_reason only)
2026-10-17 26.6.18: comments and EC I2C log text only, no logic change (UART-mode canary claim dropped, optical harness colours, missing version notes)
2026-10-29 Docs: BRS GFO & Carbon Reactor (Deluxe) — specs, expected reading effects, open to-dos (#1)
    * Docs: record BRS GFO & Carbon Reactor (Deluxe), delivered not installed
    Specs from the BRS product page, plus the ORP/pH effects to expect after
    install so they are not mistaken for probe faults. No firmware change.
    Claude-Session: https://claude.ai/code/session_01KPnW9KUcCxHBk2cgEUdkoe
    * Docs: GFO reactor run mode (24/7, ball valve) and planned automation
    Claude-Session: https://claude.ai/code/session_01KPnW9KUcCxHBk2cgEUdkoe
    * Docs: GFO reactor plan as an open to-do checklist
    Co-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
